Fadysamy101/R2_SDF_FFT/README.md

# 16-Point Radix-2 DIF SDF FFT

A fully pipelined **16-point Fast Fourier Transform (FFT)** implemented as a **Radix-2 Decimation-in-Frequency Single-Path Delay Feedback (R2SDF)** architecture.

This project was completed as part of the **Digital Summer Internship at Analog Devices, Inc.**

**Authors:** Fady Samy Nabil, Menna Assem Fouda  
**Date:** 16 August 2026

---

## Project Overview

The project covers the complete digital design flow of a streaming 16-point FFT:

- Fixed-point MATLAB system modeling
- Monte-Carlo SQNR analysis
- Parameterized RTL implementation in Verilog
- UVM-based RTL verification
- Code coverage analysis
- ASIC implementation using OpenLane and the SkyWater 130 nm PDK
- FPGA implementation and comparison against the ASIC

The final design processes **one complex input sample per clock** and uses a four-stage R2SDF pipeline.

---

## Project Status

| Design Phase | Status |
|---|---|
| System Modeling | Completed |
| RTL Design | Completed |
| RTL Verification | Completed |
| ASIC & FPGA Implementation | Completed |

---

## Repository Structure

```text
.
├── README.md
├── .gitignore
│
├── RTL_design/
│   ├── butterfly.v
│   ├── cmult.v
│   ├── sdf_stage.v
│   ├── twiddle_rom.v
│   ├── fft_wrapper.v
│   └── ...
│
├── RTL_verification/
│   └── fft_wrapper_uvm/
│       └── ...
│
├── System_modeling/
│   ├── sdf_r2_fft16_model.m
│   ├── vectors/
│   └── ...
│
├── FPGA/
│   └── R2SDF_DIF/
│       └── ...
│
├── ASIC/
│   ├── logs/
│   ├── reports/
│   └── results/
│
├── extra_implementations/
│   └── FFT_R2_DIT/
│       └── Matlab Modelling/
│
└── README_images/
    ├── architecture.png
    ├── sqnr.png
    ├── verification.png
    ├── floorplan.png
    ├── layout.png
    └── fpga_schematic.png
```

`extra_implementations/` contains an additional Radix-2 DIT implementation and its MATLAB modeling work. It is kept separate from the final R2SDF-DIF implementation presented in this project.

Generated simulator, synthesis, implementation, and MATLAB acceleration files are excluded from version control using `.gitignore`.

---

## FFT Configuration

| Parameter | Configuration |
|---|---|
| FFT size | `N = 16` |
| Architecture | Radix-2 DIF, SDF |
| Pipeline stages | 4 |
| Input order | Natural / in-order |
| Output order | Bit-reversed |
| Streaming rate | 1 complex sample / clock |
| Pipeline delays | 8, 4, 2, 1 |
| Latency | 15 clock cycles |

### R2SDF Pipeline

```text
                    ┌──────────────┐
in_re/in_im ───────►│ Stage 1      │
                    │ Delay = 8    │
                    └──────┬───────┘
                           │
                    ┌──────▼───────┐
                    │ Stage 2      │
                    │ Delay = 4    │
                    └──────┬───────┘
                           │
                    ┌──────▼───────┐
                    │ Stage 3      │
                    │ Delay = 2    │
                    └──────┬───────┘
                           │
                    ┌──────▼───────┐
                    │ Stage 4      │
                    │ Delay = 1    │
                    └──────┬───────┘
                           │
                    out_re/out_im
```

The first valid output appears **15 clock cycles after the first input sample**.

Stages 3 and 4 use simplified wiring-only twiddle operations where possible, avoiding unnecessary multiplier and ROM hardware.

---

## System Modeling

The MATLAB model is used as the fixed-point golden reference and for Monte-Carlo performance analysis.

### Fixed-Point Formats

| Component | Format |
|---|---|
| Main datapath | Q3.9, 12-bit signed |
| Twiddle ROM | Q2.10, 12-bit signed |
| Stage scaling | `>> 1` per stage |
| Multiplier rounding | Round-to-nearest |

Each stage scales its output by 2 to keep the datapath width constant. Across four stages, the fixed-point FFT output is therefore scaled by:

```text
X[k] / 16
```

The complex multiplier adds a half-LSB before truncation to implement round-to-nearest.

### SQNR Results

The fixed-point model was compared against MATLAB's floating-point `fft()` across **100 random seeds**.

| Data type | Average SQNR |
|---|---:|
| Double | 110.34 dB |
| Single | 110.38 dB |
| Fixed-point | **51.8 dB** |

The fixed-point implementation achieved **51.8 dB SQNR**, exceeding the **40 dB pass threshold**.

The maximum fixed-point error observed across the 100 seeds was approximately **0.07**.

---

## RTL Architecture

The RTL is modular and parameterized.

### Main RTL Blocks

- `fft_wrapper`
- `sdf_stage`
- `butterfly`
- `cmult`
- `twiddle_rom`

### Design Features

- **Parameterized datapath:** data and twiddle widths are module parameters.
- **Reusable `sdf_stage`:** the same stage module is instantiated four times with different delay/configuration values.
- **Stage-specific optimization:** later stages use simplified wiring-only operations instead of unnecessary multiplier/ROM hardware.
- **Modular implementation:** butterfly, complex multiplier, twiddle ROM, and SDF stage are separate reusable RTL blocks.
- **Extensible architecture:** a larger FFT can be created by appending stages and extending the twiddle ROM.

For example, extending the architecture to a 32-point FFT requires another SDF stage and the corresponding twiddle coefficients.

---

## RTL Verification

Verification was performed using a **UVM-based verification environment**.

### Verification Flow

```text
MATLAB Model
     │
     ▼
Generate fixed-point reference vectors
     │
     ▼
Directed hexadecimal input vectors
     │
     ▼
      UVM Testbench
     │
     ├──► DUT
     │
     └──► Scoreboard
              │
              ▼
       Compare against
       MATLAB reference
```

The verification environment accounts for the **15-cycle pipeline latency** and models the fixed-point arithmetic to match the RTL scaling and rounding behavior.

### Verification Results

- **20 FFT frames**
- **16 samples/frame**
- **320 samples compared**
- **0 mismatches**
- **Worst-case error: 0 LSB**

### Coverage

| Metric | Result |
|---|---:|
| Statement coverage | 100% |
| Condition coverage | 100% |
| Expression coverage | 100% |
| Branch coverage | ≈95% |
| Toggle coverage | ≈86% |
| Assertion coverage | 100% (3/3) |

The remaining branch/toggle coverage is associated with unused or unreachable control paths, stage-specific behavior, and signals that remain inactive during valid 16-point FFT operation.

---

## ASIC Implementation

The design was hardened using **OpenLane** with the **SkyWater 130 nm PDK**.

### Configuration

| Parameter | Value |
|---|---|
| Tool | OpenLane |
| PDK | SkyWater 130 nm (`sky130A`) |
| Standard-cell library | `sky130_fd_sc_hd` |
| Target clock period | 20 ns |
| Target frequency | 50 MHz |
| Setup uncertainty | 100 ps |
| Hold uncertainty | 200 ps |

The complete OpenLane hardening flow completed successfully with no setup, hold, or ERC violations.

### Timing Results

| Metric | Result |
|---|---:|
| Clock period | 20.00 ns |
| Critical path delay | 14.37 ns |
| Maximum frequency | **69.59 MHz** |
| WNS | +5.63 ns |
| TNS | 0.00 ns |

### Area Results

| Metric | Result |
|---|---:|
| Die area | **0.5944 mm²** |
| Core area | **0.5684 mm²** |
| Post-route utilization | **25.59%** |
| Approx. die dimensions | 771 × 771 µm |
| Core dimensions | ≈ 753.9 × 753.9 µm |

---

## FPGA vs ASIC

The design was also implemented on a **Xilinx XC7Z020 (-2)** FPGA.

| Metric | FPGA | ASIC |
|---|---:|---:|
| Technology | XC7Z020, -2 | SkyWater 130 nm |
| Maximum frequency | 63.85 MHz | **69.59 MHz** |
| Area | 472 LUTs, 376 FFs, 8 DSPs | 0.5944 mm² die area |
| Timing | Setup & Hold Met | Setup & Hold Met |

The FPGA maximum frequency is approximately **8.25% lower** than the ASIC result.

Despite the significant technology gap between the XC7Z020 FPGA and the 130 nm ASIC, their maximum operating frequencies are relatively close. The FPGA implementation benefits from **dedicated DSP blocks** for arithmetic operations.

---

## Key Results

### Functional

- Fully pipelined 16-point R2SDF DIF FFT
- One complex sample accepted per clock
- 15-cycle latency to the first valid output
- Natural-order input
- Bit-reversed output
- 320/320 verification samples matched
- 0 LSB worst-case verification error

### Numerical

- Fixed-point average SQNR: **51.8 dB**
- SQNR target: **40 dB**
- Maximum observed fixed-point error: **≈0.07**

### ASIC

- Technology: **SkyWater 130 nm**
- Maximum frequency: **69.59 MHz**
- Critical path: **14.37 ns**
- Die area: **0.5944 mm²**
- Post-route utilization: **25.59%**
- No setup/hold/ERC violations

### FPGA

- Device: **XC7Z020 (-2)**
- Maximum frequency: **63.85 MHz**
- Resources: **472 LUTs, 376 FFs, 8 DSPs**
- Frequency difference from ASIC: **8.25%**

---

## Tools & Technologies

- **MATLAB / Fixed-Point Designer** — system modeling and numerical analysis
- **Verilog** — RTL implementation
- **SystemVerilog / UVM** — verification
- **OpenLane** — ASIC implementation
- **SkyWater 130 nm PDK** — ASIC technology
- **Xilinx XC7Z020 FPGA** — FPGA implementation

---

## Authors

**Fady Samy Nabil**  
**Menna Assem Fouda**

Digital Summer Internship  
**Analog Devices, Inc.**
