Fadysamy101/R2_SDF_FFT/RTL_design/schematic.pdf

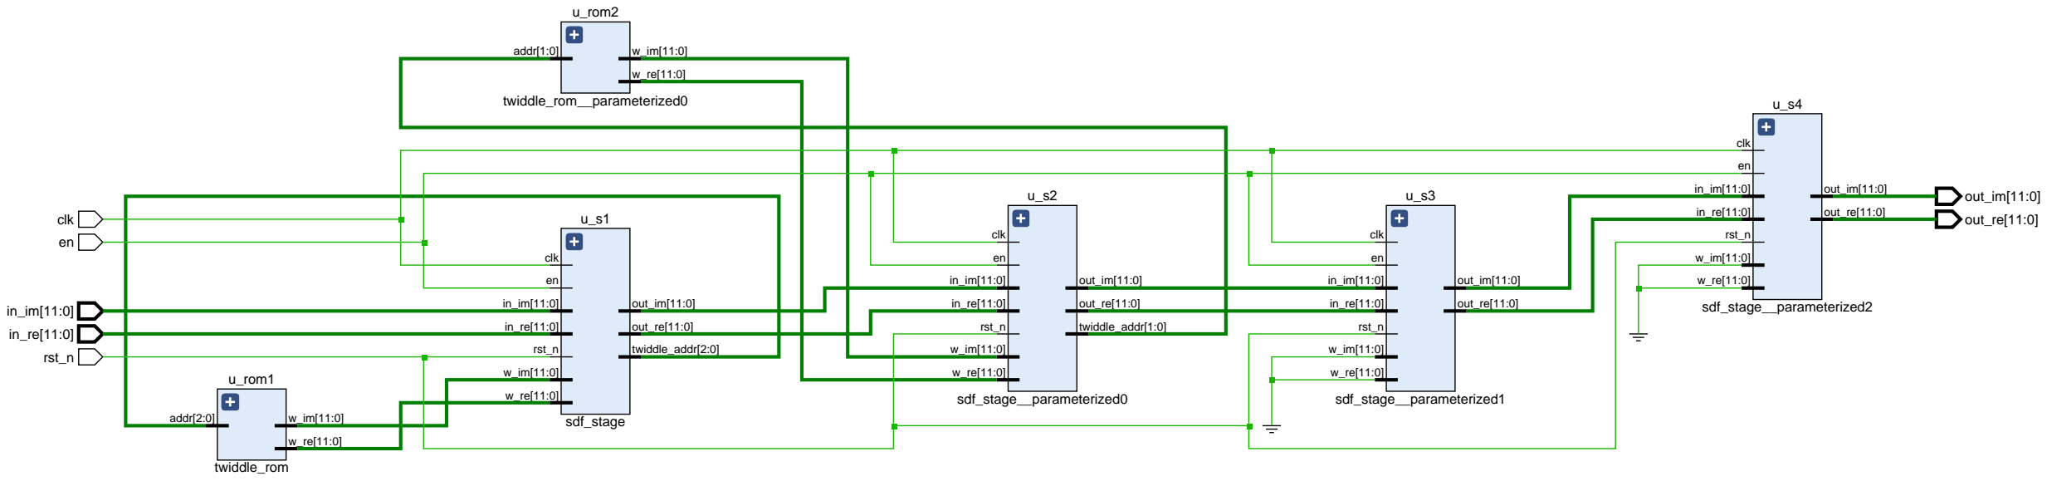
[picture p1: figure]
clk; out_im[11:0]; out_re[11:0]; rst_n; u_rom1; twiddle_rom; addr[2:0]; u_rom2; twiddle_rom__parameterized0; addr[1:0]; sdf_stage; twiddle_addr[2:0]; sdf_stage__parameterized0; twiddle_addr[1:0]; sdf_stage__parameterized1; sdf_stage__parameterized2
