Fadysamy101/R2_SDF_FFT/ASIC/reports/routing/24-wire_lengths.csv

net | length_um
net34 | 1267.8
net70 | 1159.64
net69 | 1143.14
net49 | 1132.68
net68 | 1119.47
net71 | 1112.3
net48 | 1015.88
_06781_ | 998.37
net61 | 982.61
net38 | 979.96
net51 | 935.72
_08734_ | 922.52
net16 | 902.76
net5 | 877.26
net32 | 866.72
net3 | 860.07
net42 | 819.24
net20 | 784.51
net54 | 768.025
net18 | 743.98
net28 | 743.14
_14074_ | 742.14
net31 | 719.6
_14065_ | 717.42
net4 | 717.1
net67 | 714.23
net29 | 705.945
net64 | 705.4
net45 | 705.055
net6 | 701.14
clknet_0_clk | 699.78
net52 | 698.7
_06516_ | 695.7
net13 | 693.22
net36 | 677.76
net8 | 677.07
_14078_ | 675.82
_01225_ | 667.75
_07054_ | 645.92
net24 | 634.73
net21 | 632.88
net33 | 625.66
net12 | 619
net1 | 614.72
net2 | 612.27
net23 | 597.24
_07347_ | 591.27
_07575_ | 590.64
net15 | 582.68
clk | 582.09
_01488_ | 576.28
_09615_ | 563.95
net63 | 537.82
net59 | 526.34
net35 | 525.02
net57 | 523.6
net44 | 520.87
_09085_ | 511.32
net26 | 510.815
net17 | 496.48
net39 | 487.72
net9 | 487
_08733_ | 482.14
net19 | 481.445
_08735_ | 479.72
_08695_ | 479.48
_09451_ | 477.98
_08696_ | 475.05
_00557_ | 466.67
net62 | 466.57
_08777_ | 465.49
_09450_ | 464.59
net14 | 459.92
_01000_ | 458.4
net27 | 456.18
_08025_ | 451.19
net50 | 450.84
clknet_3_5__leaf_clk | 449.27
_11429_ | 448.61
net30 | 446.82
_01004_ | 446.34
clknet_3_7__leaf_clk | 441.945
net7 | 441.42
_00546_ | 437.47
_14067_ | 437.02
_08258_ | 436.32
_09809_ | 435.79
_09792_ | 434.76
_07933_ | 434.64
_09284_ | 430.84
_08041_ | 426.15
_09627_ | 425.06
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
_07665_ | 38.54
_01666_ | 38.505
_00871_ | 38.5
_07593_ | 38.5
_08300_ | 38.5
_08761_ | 38.5
_02940_ | 38.48
_05721_ | 38.48
_02431_ | 38.46
_09352_ | 38.46
_01448_ | 38.445
_04020_ | 38.42
_04579_ | 38.42
_13019_ | 38.36
_08261_ | 38.34
_04299_ | 38.31
_12803_ | 38.3
_07815_ | 38.28
_01381_ | 38.275
_05346_ | 38.26
_07422_ | 38.26
_03225_ | 38.24
_03316_ | 38.22
_09952_ | 38.22
_12412_ | 38.22
_03338_ | 38.16
_14179_ | 38.16
_14296_ | 38.16
_12085_ | 38.12
_11563_ | 38.095
_06582_ | 38.04
_07731_ | 38.04
_08014_ | 38.04
_11018_ | 38.04
_00761_ | 38.02
_02418_ | 38.02
_03721_ | 38
_08092_ | 38
_07862_ | 37.96
_13283_ | 37.96
_01878_ | 37.9
_03070_ | 37.9
_07762_ | 37.9
_09975_ | 37.9
_12195_ | 37.9
_06009_ | 37.88
_02536_ | 37.86
_08194_ | 37.855
_07608_ | 37.84
_07147_ | 37.82
_00576_ | 37.8
_01967_ | 37.8
_05880_ | 37.8
_08086_ | 37.78
_02759_ | 37.755
_05019_ | 37.75
_02052_ | 37.72
_03787_ | 37.72
_10770_ | 37.72
_13021_ | 37.72
_08277_ | 37.7
_11657_ | 37.7
_11997_ | 37.7
_07068_ | 37.65
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
