Fadysamy101/R2_SDF_FFT/extra_implementations/FFT_R2_DIT/Matlab Modelling/Figures/Error_for_double_datatybe.jpg

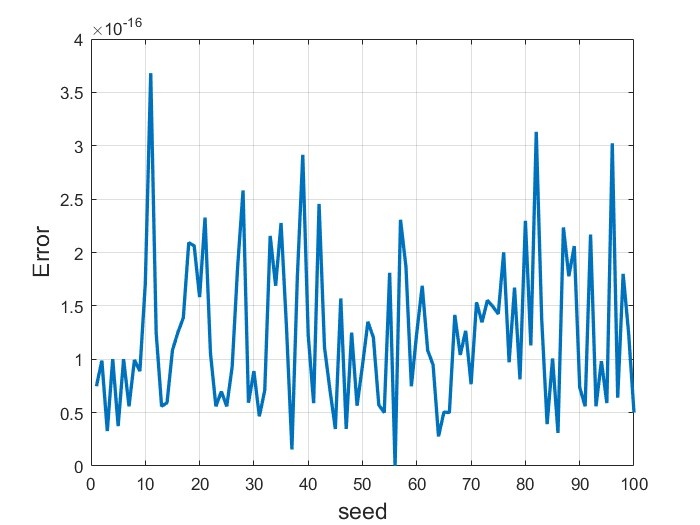
extra_implementations/FFT_R2_DIT/Matlab Modelling/Figures/Error_for_double_datatybe.jpg
