Fadysamy101/R2_SDF_FFT/extra_implementations/FFT_R2_DIT/Matlab Modelling/Figures/Instrumentation_1.png

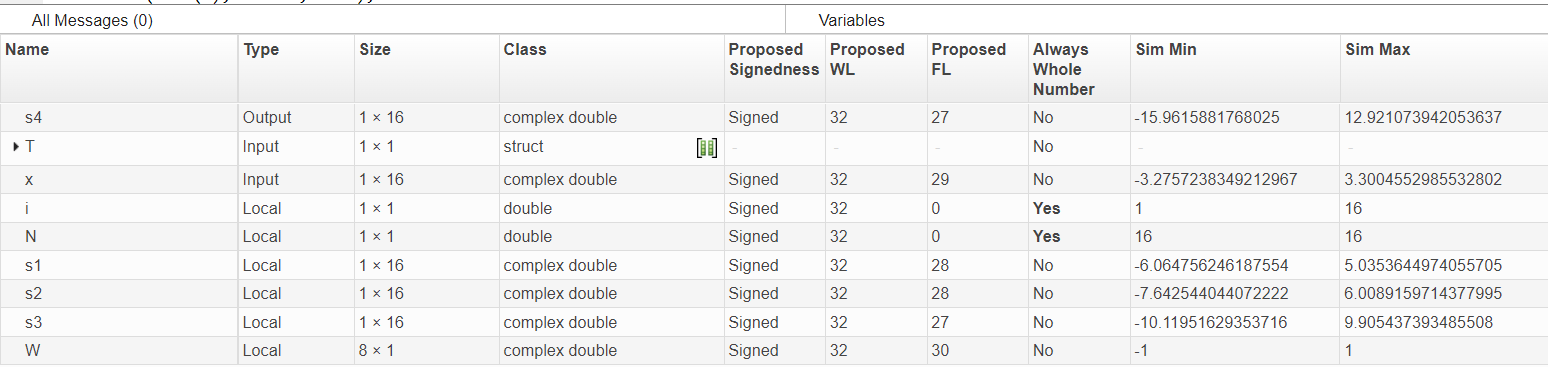
extra_implementations/FFT_R2_DIT/Matlab Modelling/Figures/Instrumentation_1.png
