Fadysamy101/R2_SDF_FFT/extra_implementations/FFT_R2_DIT/Matlab Modelling/Figures/sqnr_double.jpg

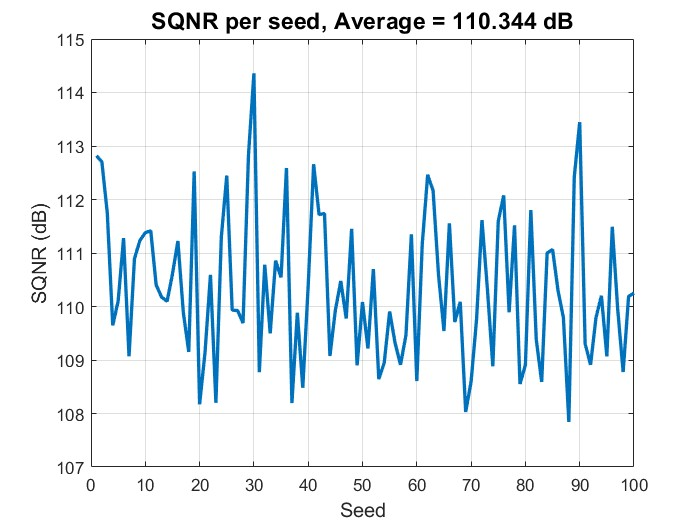
extra_implementations/FFT_R2_DIT/Matlab Modelling/Figures/sqnr_double.jpg
