Fadysamy101/R2_SDF_FFT/System_modeling/worst_error.png

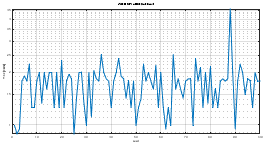
System_modeling/worst_error.png
