Fadysamy101/R2_SDF_FFT/ASIC/reports/metrics.csv

design | design_name | config | flow_status | total_runtime | routed_runtime | (Cell/mm^2)/Core_Util | DIEAREA_mm^2 | CellPer_mm^2 | OpenDP_Util | Final_Util | Peak_Memory_Usage_MB | synth_cell_count | tritonRoute_violations | Short_violations | MetSpc_violations | OffGrid_violations | MinHole_violations | Other_violations | Magic_violations | pin_antenna_violations | net_antenna_violations | lvs_total_errors | cvc_total_errors | klayout_violations | wire_length | vias | wns | pl_wns | optimized_wns | fastroute_wns | spef_wns | tns | pl_tns | optimized_tns | fastroute_tns | spef_tns | HPWL | routing_layer1_pct | routing_layer2_pct | routing_layer3_pct | routing_layer4_pct | routing_layer5_pct | routing_layer6_pct | wires_count | wire_bits | public_wires_count | public_wire_bits | memories_count | memory_bits | processes_count | cells_pre_abc | AND | DFF | NAND | NOR | OR | XOR | XNOR | MUX
/openlane/designs/FFT | fft_wrapper | full_flow_4 | flow completed | 0h25m16s0ms | 0h18m17s0ms | 102735.37636902907 | 0.5943814307999999 | 25683.844092257266 | 25.59 | -1 | 1906.02 | 15035 | 0 | 0 | 0 | 0 | 0 | 0 | 0 | 27 | 24 | 0 | -1 | -1 | 642945 | 107475 | 0.0 | -1 | -1 | -1 | 0.0 | 0.0 | -1 | -1 | -1 | 0.0 | 548711947.0 | 0.0 | 30.38 | 30.59 | 8.58 | 12.26 | 4.35 | 15942 | 17763 | 142 | 1963 | 0 | 0 | 0 | 16457 | 169 | 0 | 289 | 1733 | 1803 | 3510 | 1562 | 542
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
