Fadysamy101/R2_SDF_FFT/FPGA/R2SDF_DIF/schematic.pdf

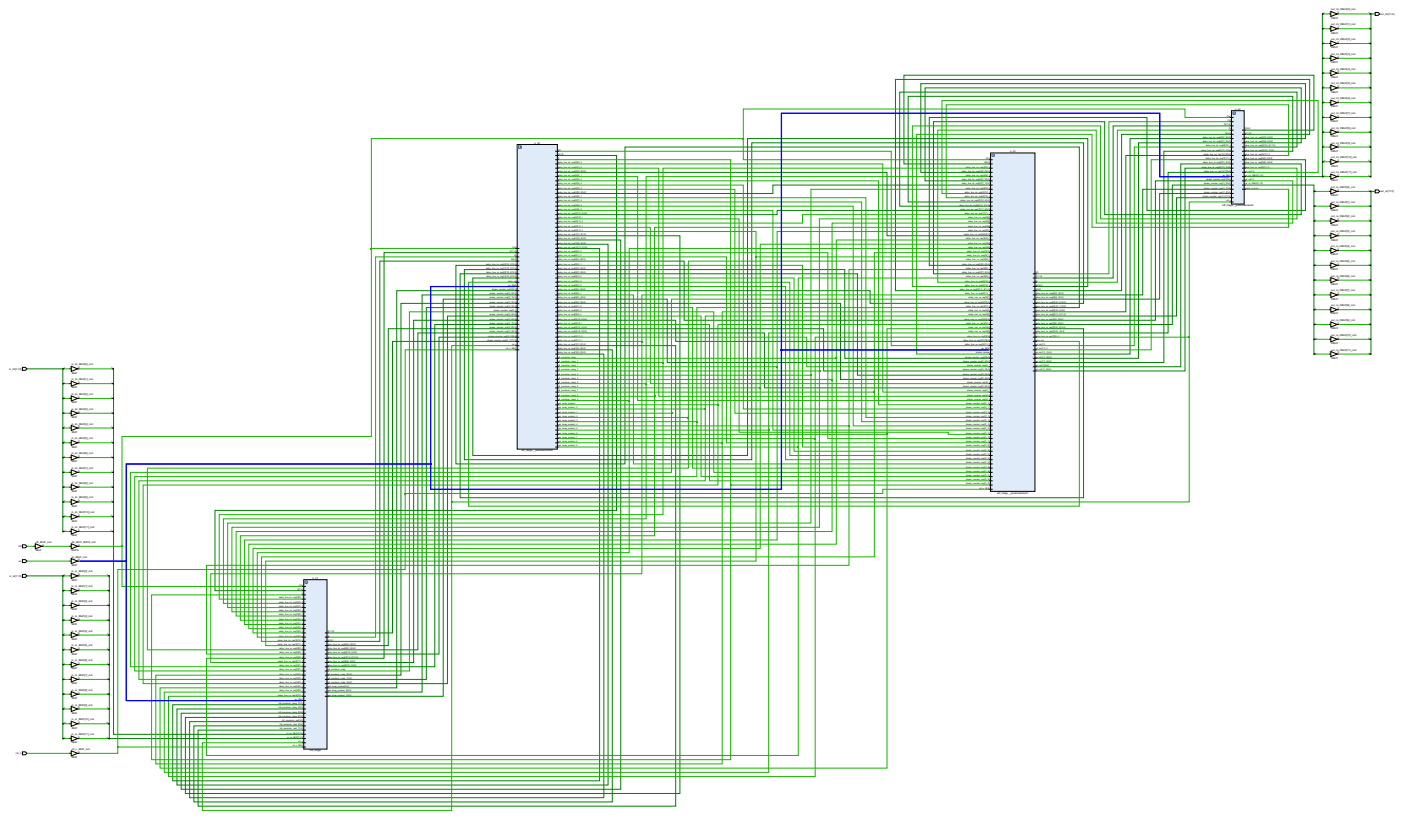
[picture p10: page 1]
clk; rst_n; clk_IBUF_inst; IBUF I; in_im_IBUF[0]_inst; in_im_IBUF[1]_inst; in_im_IBUF[2]_inst; in_im_IBUF[3]_inst; in_im_IBUF[4]_inst; in_im_IBUF[5]_inst; in_im_IBUF[6]_inst; in_im_IBUF[7]_inst; in_im_IBUF[8]_inst; in_im_IBUF[9]_inst; in_im_IBUF[10]_inst; in_im_IBUF[11]_inst; clk_IBUF_BUFG_inst BUFG I; en_IBUF_inst; in_re_IBUF[0]_inst; in_re_IBUF[1]_inst; in_re_IBUF[2]_inst; in_re_IBUF[3]_inst; in_re_IBUF[4]_inst; in_re_IBUF[5]_inst; in_re_IBUF[6]_inst; in_re_IBUF[7]_inst; in_re_IBUF[8]_inst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
