Fadysamy101/R2_SDF_FFT/(commit log)

2026-08-12 Fixed test ending too early
    [fft_wrapper_scoreboard.sv, fft_wrapper_test.sv]
2026-08-14 made rtl uvm fixed point format match matlab model
    [cmult.v, fft_cfg_pkg.sv, fft_matlab_seq.sv, fft_wrapper.v, fft_wrapper_inter.sv, fft_wrapper_scoreboard.sv, fft_wrapper_seq_item.sv, fft_wrapper_top.sv]
2026-08-15 asic flow results and reports
    [24-wire_lengths.csv, metrics.csv]
